RodrigoMCOlv/LABSI/NetPage_LABSI/Render2LABSI.png

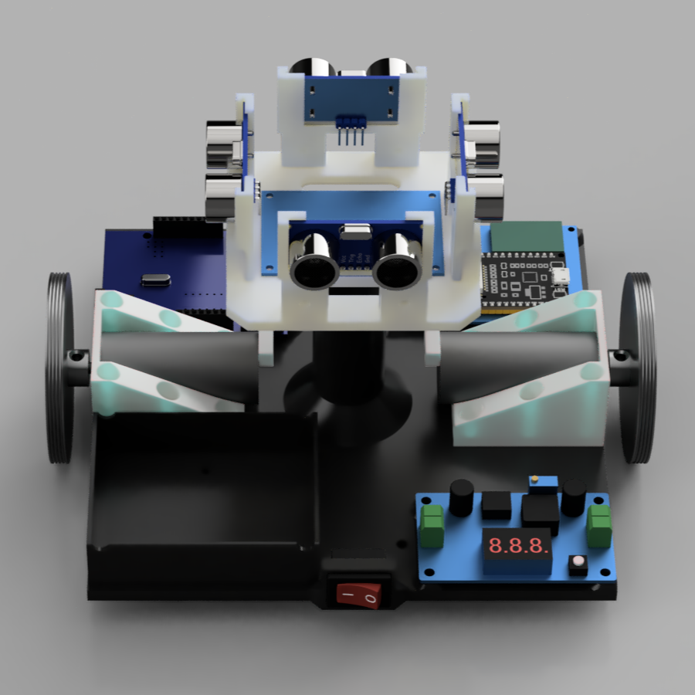
NetPage_LABSI/Render2LABSI.png
