RodrigoMCOlv/LABSI/NetPage_LABSI/Robot.jpg

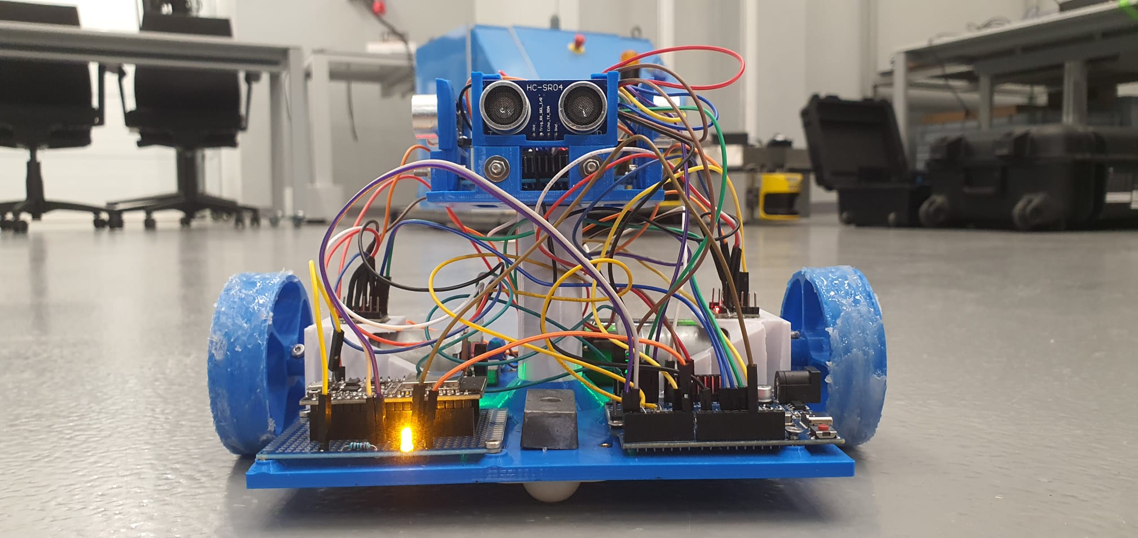
NetPage_LABSI/Robot.jpg
