RodrigoMCOlv/LABSI/README.md

# LABSI
A course project that I want to make publicly available
