RodrigoMCOlv/LABSI/Extra/MotorDriverLigações.png

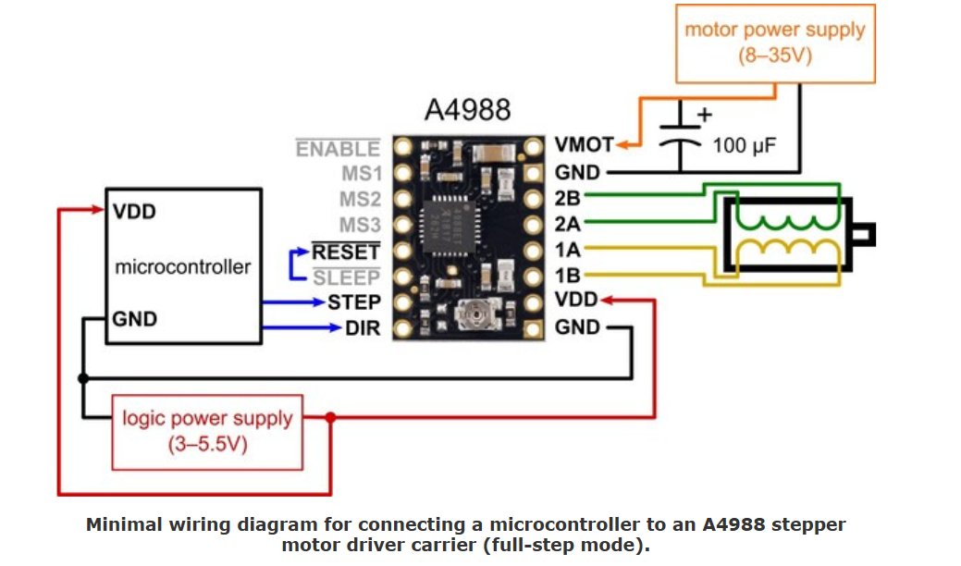
Extra/MotorDriverLigações.png
