RodrigoMCOlv/LABSI/Extra/MotorEncoderLigaçõoes.png

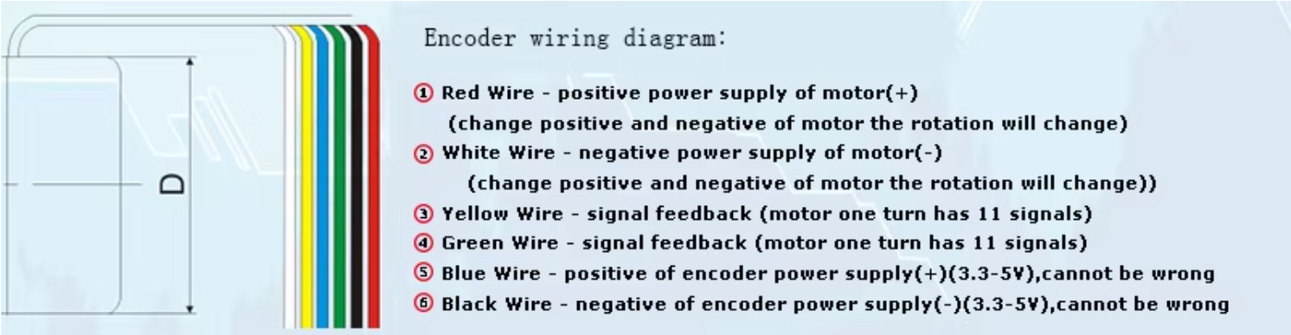
Extra/MotorEncoderLigaçõoes.png
