RodrigoMCOlv/LABSI/NetPage_LABSI/DetArch.png

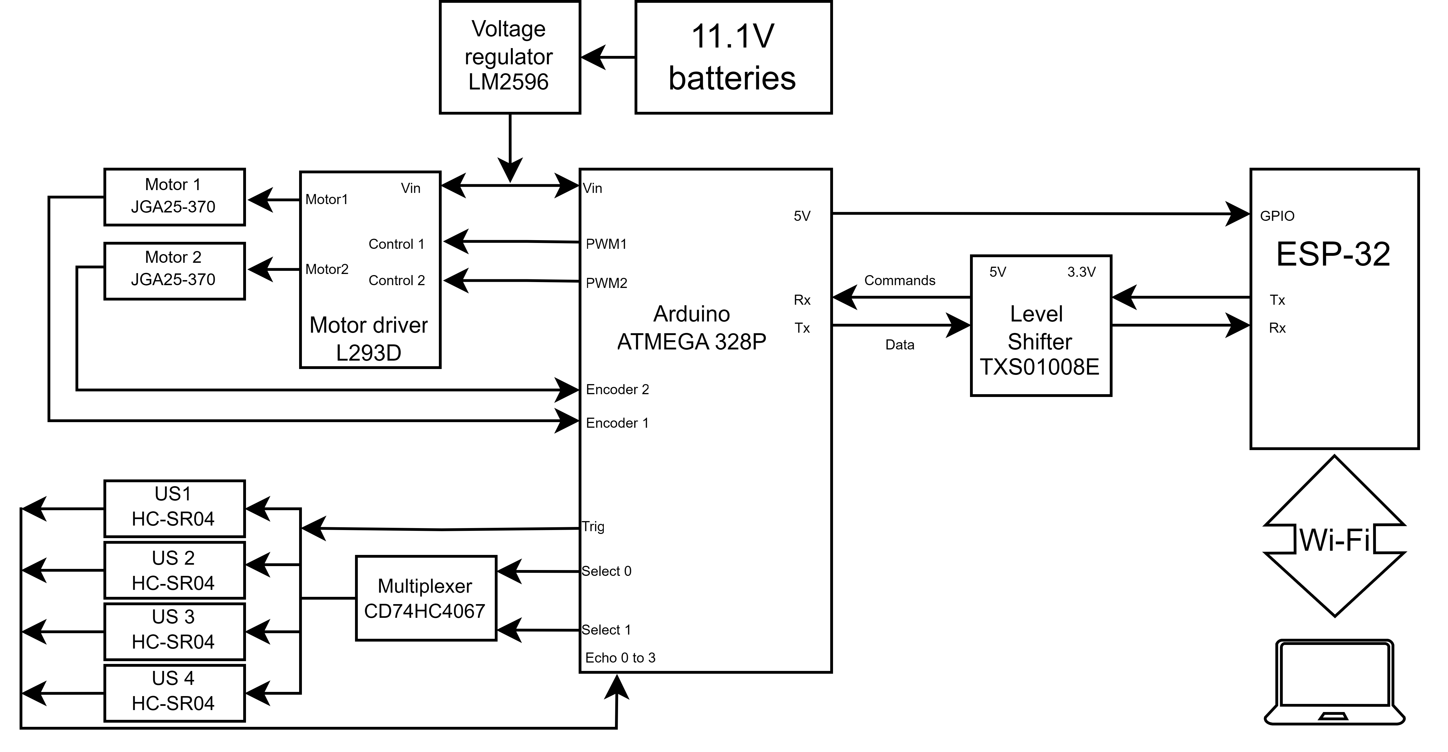
NetPage_LABSI/DetArch.png
