RodrigoMCOlv/LABSI/NetPage_LABSI/FluxMotores.png

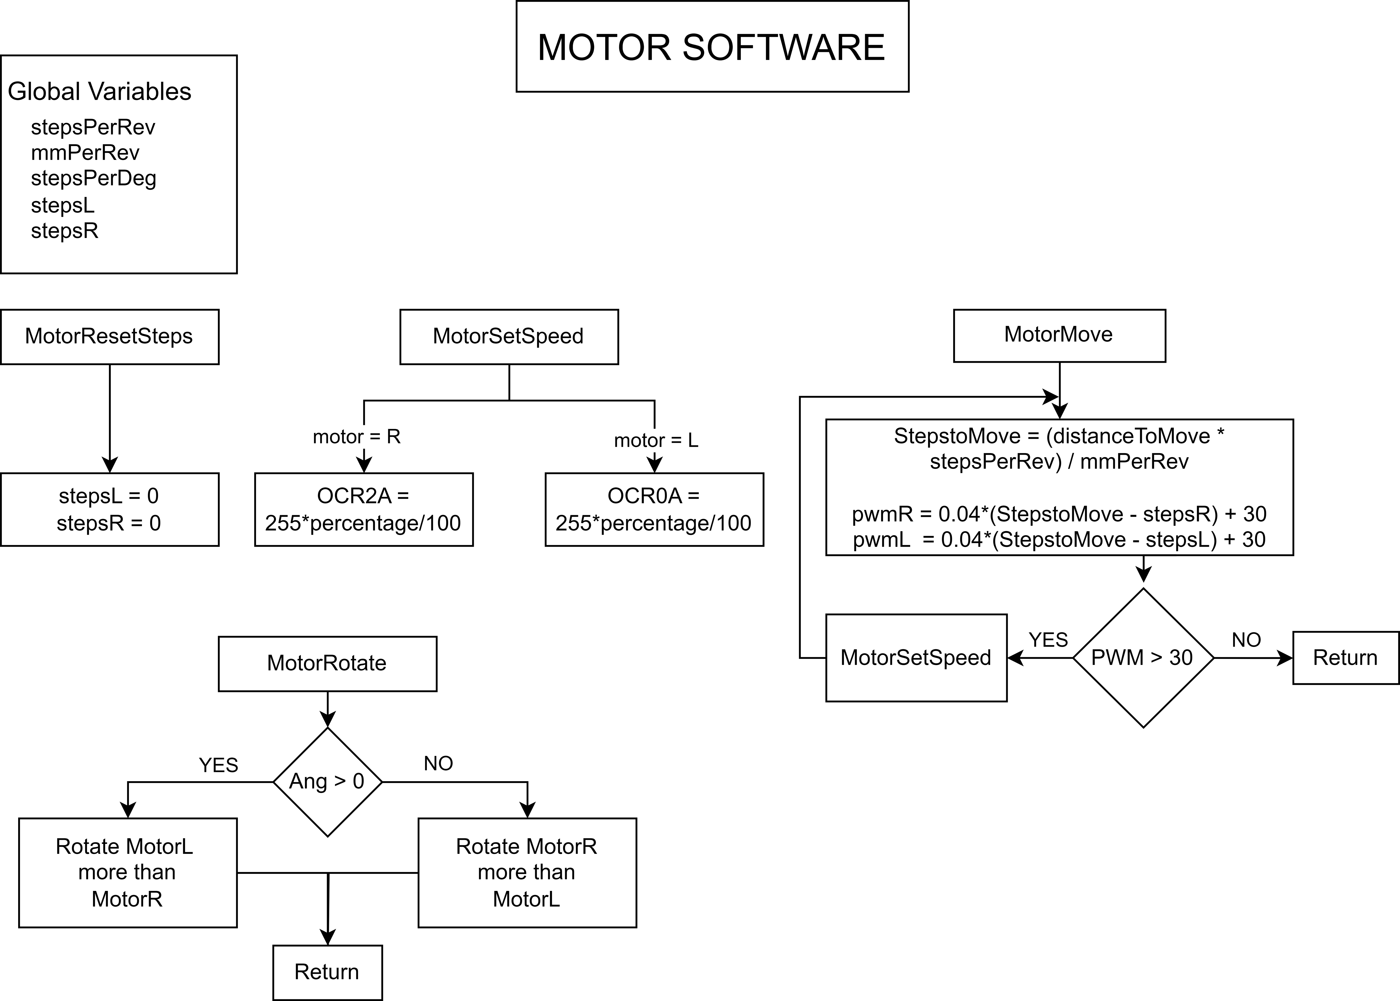
NetPage_LABSI/FluxMotores.png
