RodrigoMCOlv/LABSI/NetPage_LABSI/FluxUS.png

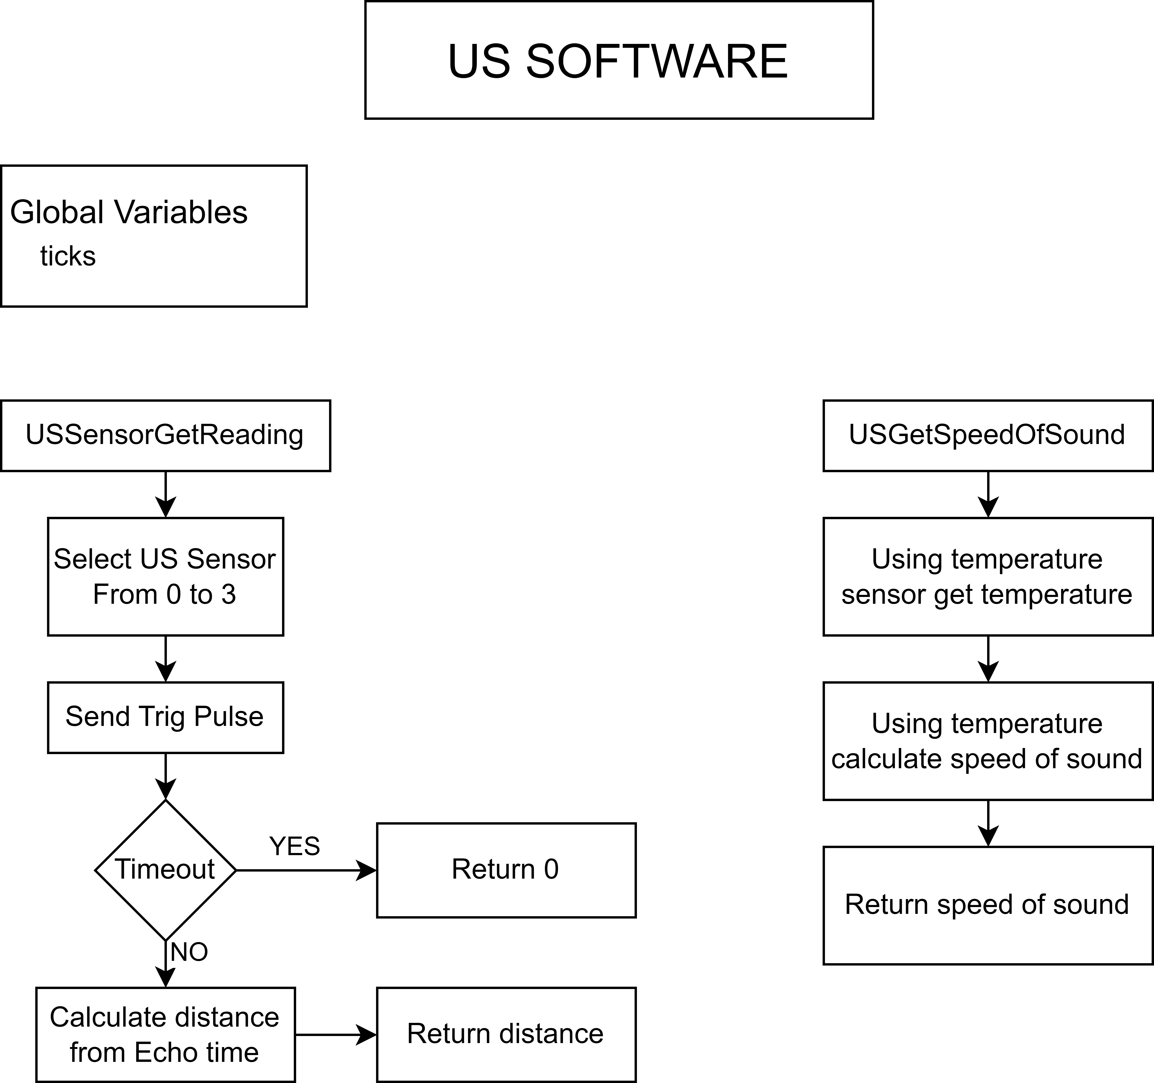
NetPage_LABSI/FluxUS.png
