RodrigoMCOlv/LABSI/NetPage_LABSI/InitDiag.png

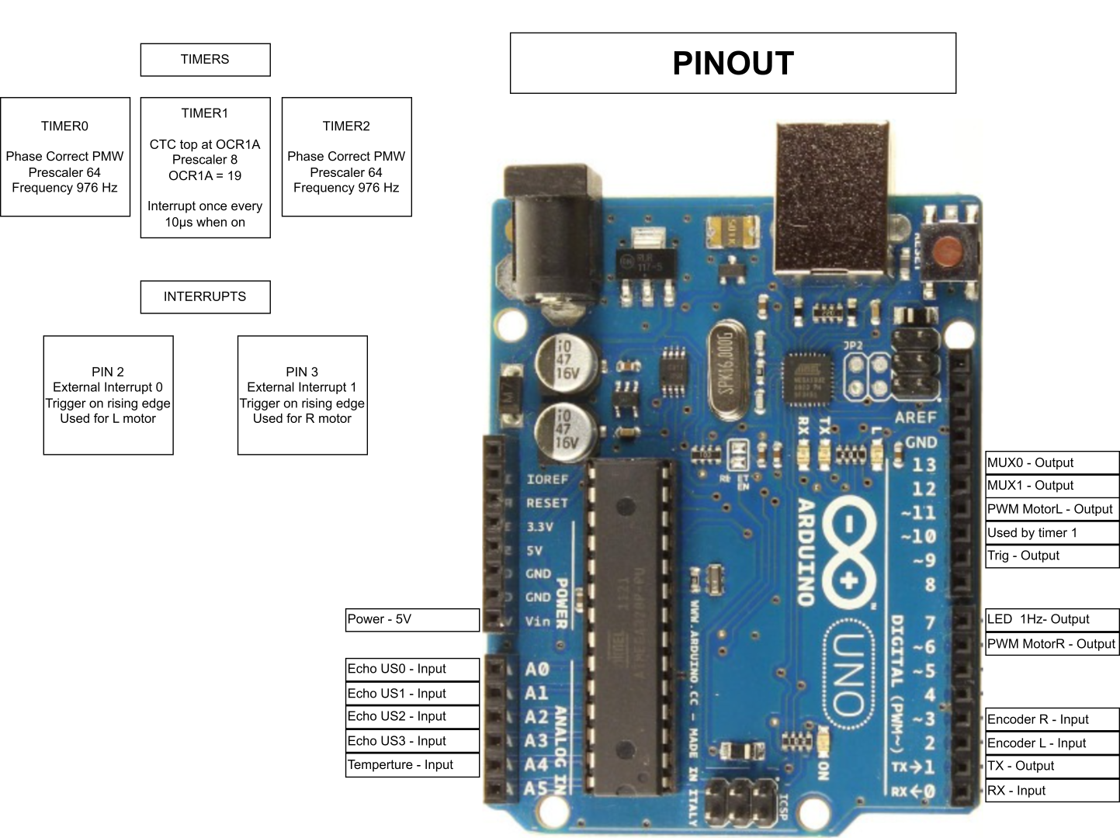
NetPage_LABSI/InitDiag.png
