RodrigoMCOlv/LABSI/NetPage_LABSI/Map.png

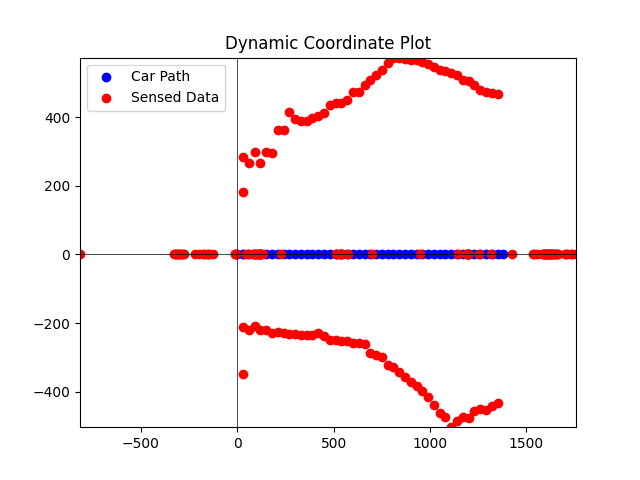
NetPage_LABSI/Map.png
