RodrigoMCOlv/LABSI/NetPage_LABSI/MappedArea.jpg

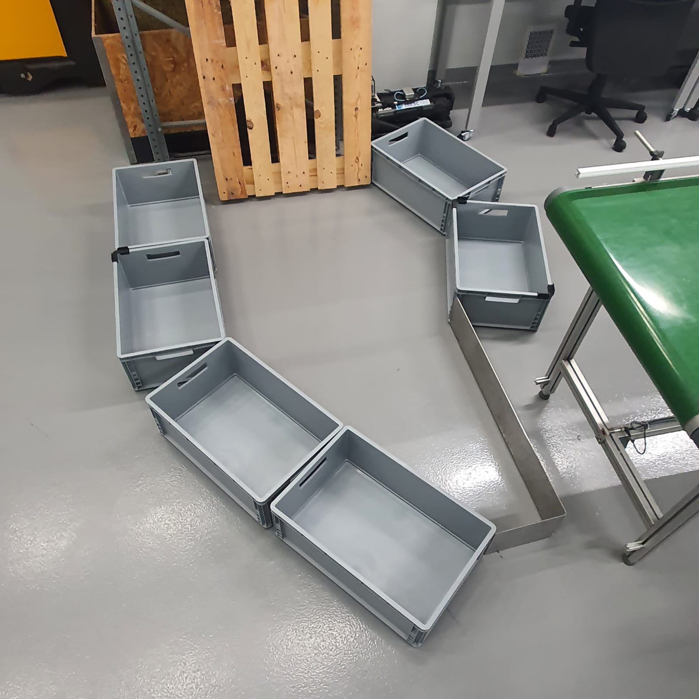
NetPage_LABSI/MappedArea.jpg
