RodrigoMCOlv/LABSI/NetPage_LABSI/PCB2.png

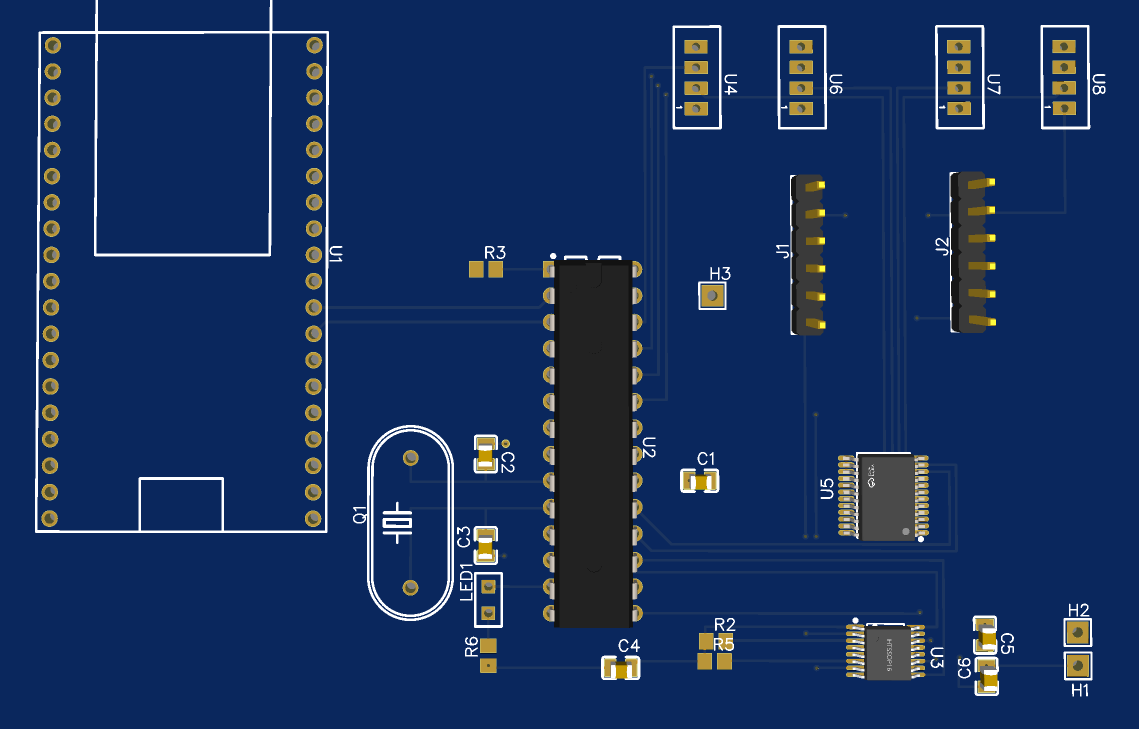
NetPage_LABSI/PCB2.png
