RodrigoMCOlv/LABSI/NetPage_LABSI/PCB.png

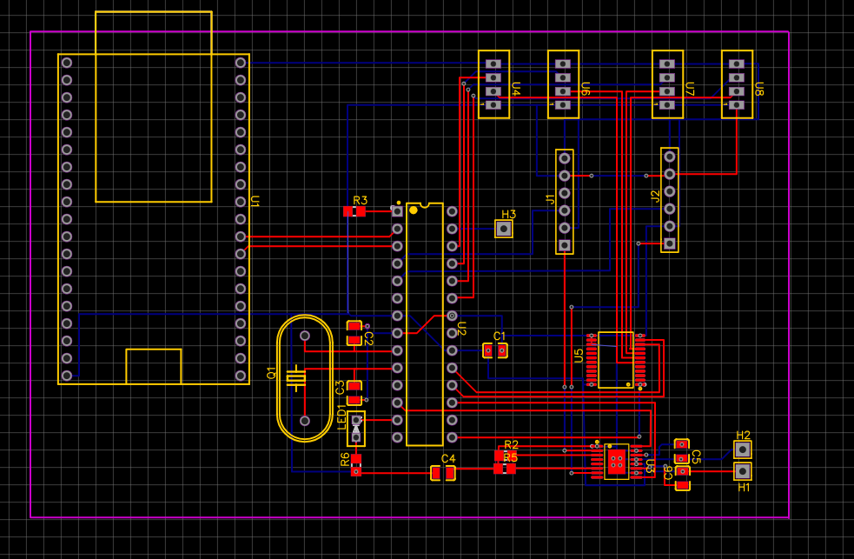
NetPage_LABSI/PCB.png
