RodrigoMCOlv/LABSI/NetPage_LABSI/Render1LABSI.png

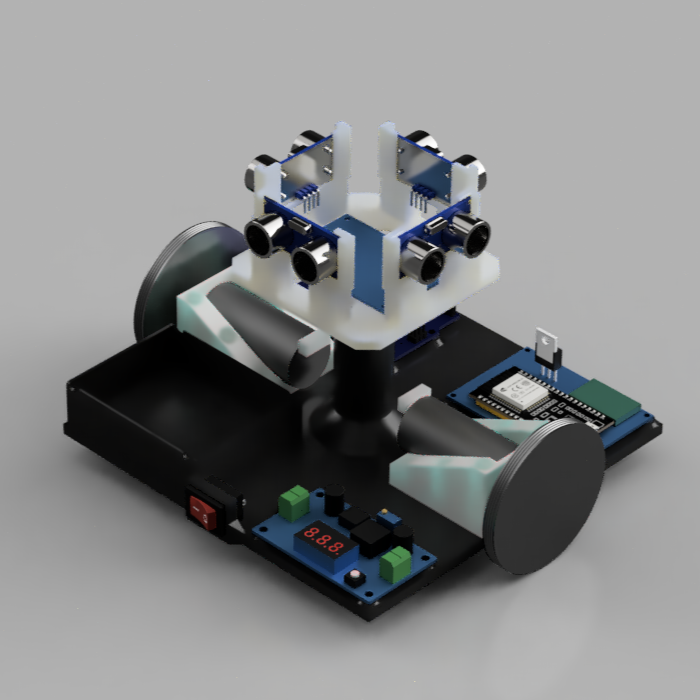
NetPage_LABSI/Render1LABSI.png
