RodrigoMCOlv/LABSI/NetPage_LABSI/Robot2.jpg

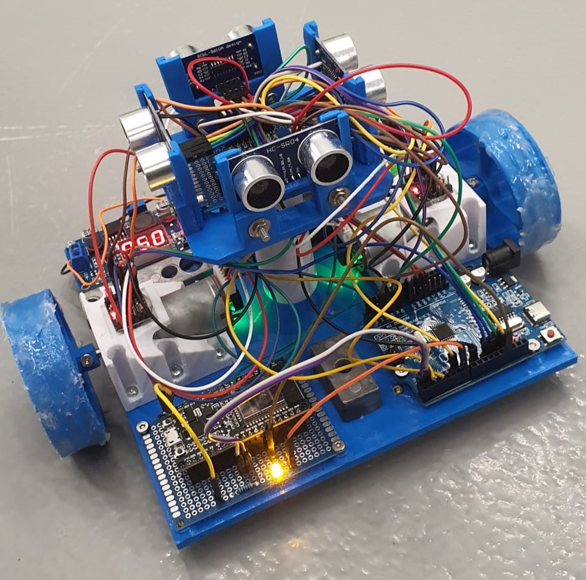
NetPage_LABSI/Robot2.jpg
