RodrigoMCOlv/LABSI/NetPage_LABSI/Wheels.jpg

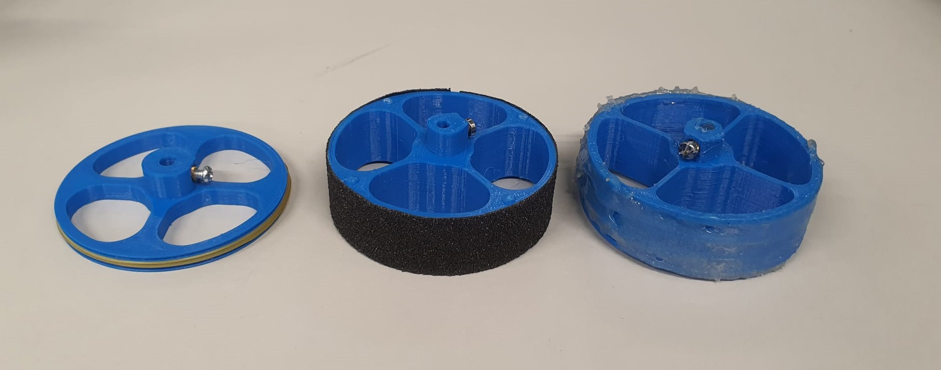
NetPage_LABSI/Wheels.jpg
