RodrigoMCOlv/LABSI/NetPage_LABSI/WI-FIFunc.png

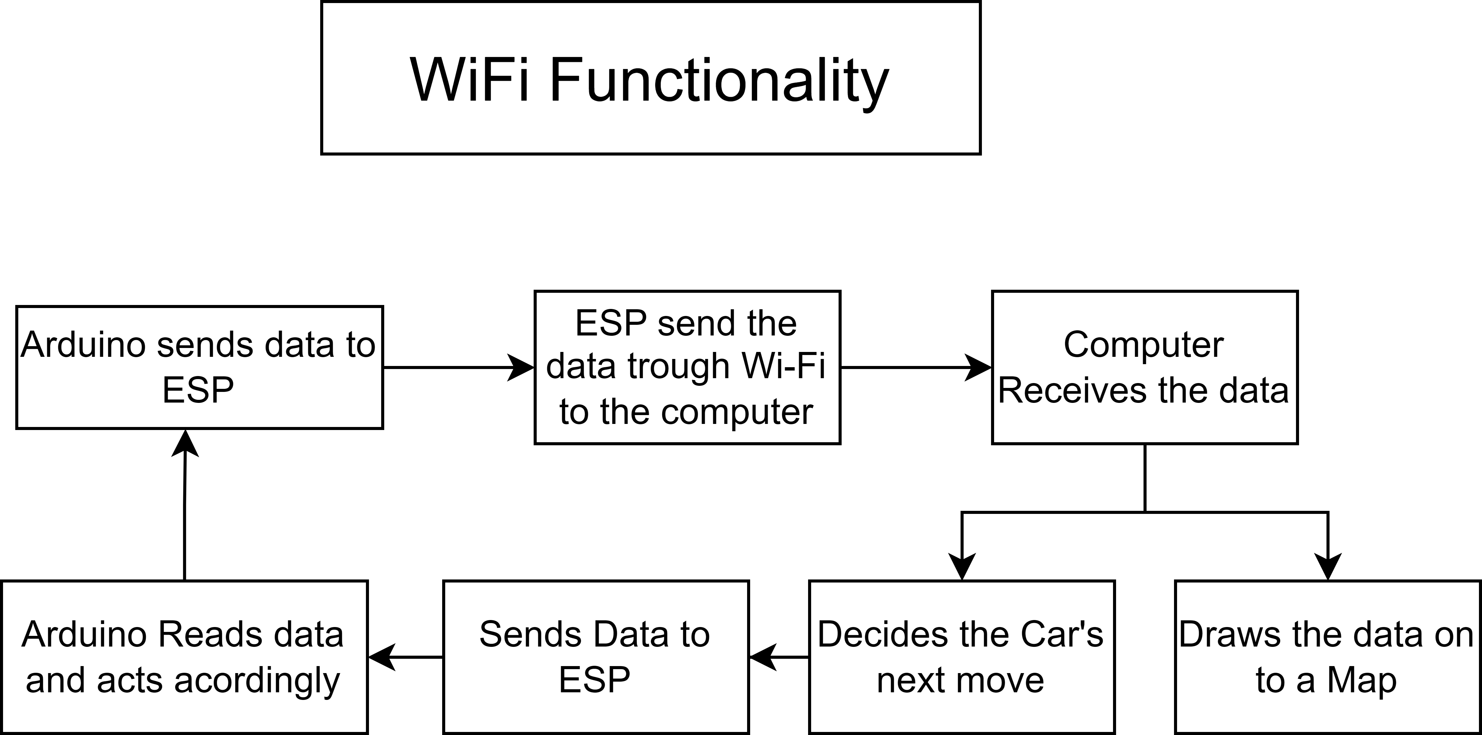
NetPage_LABSI/WI-FIFunc.png
